SySch415/MITE-ESC/hardware/MITE_v1.csv

Reference | Qty | Value | DNP | Exclude from BOM | Exclude from Board | Footprint | MPN | Manufacturer | LCSC Part
Y_nrf_1 | 1 | Crystal_4pin_GND24 |  |  |  | Crystal:Crystal_SMD_3225-4Pin_3.2x2.5mm | ABM8AIG-16.000MHZ-12-2Z-T3 | Abracon
Y_M_1 | 1 | Crystal_4pin_GND24 |  |  |  | Crystal:Crystal_SMD_3225-4Pin_3.2x2.5mm | ABM8N-25.0000MHZ-10-D2Y-T3 | Abracon
U6 | 1 | NRF24L01 |  |  |  | Package_DFN_QFN:QFN-20-1EP_4x4mm_P0.5mm_EP2.5x2.5mm | NRF24L01P-R | Nordic Semiconductor
U4 | 1 | TB6612FNG |  |  |  | Package_SO:SSOP-24_5.3x8.2mm_P0.65mm | TB6612FNG,C,8,EL | Toshiba | C141517
U2,U3 | 2 | RY8336 |  |  |  | easyeda2kicad:ESOP-8_L4.9-W3.9-P1.27-LS6.0-BL-EP-1 | RY8336 | RYCHiP(蕊源) | C370879
U1 | 1 | STM32F411CEUx |  |  |  | Package_DFN_QFN:QFN-48-1EP_7x7mm_P0.5mm_EP5.6x5.6mm | STM32F411CEU6 | STMicroelectronics
SW_rst_2 | 1 | nrst_switch |  |  |  | Button_Switch_SMD:SW_Push_1P1T_NO_CK_KMR2 | KMR211NG LFS | C&K
SW_B_1 | 1 | boot switch |  |  |  | Button_Switch_SMD:SW_Push_1P1T_NO_CK_KMR2 | KMR211NG LFS | C&K
R_nrf_2 | 1 | 1M |  |  |  | Resistor_SMD:R_0603_1608Metric | RC0603FR-071ML | Yageo
R_nrf_1 | 1 | 22k |  |  |  | Resistor_SMD:R_0603_1608Metric | RC0603FR-0722KL | Yageo
R_L_2 | 1 | 5.1K |  |  |  | Resistor_SMD:R_0603_1608Metric | RC0603FR-075K1L | Yageo
R_L_1 | 1 | 1K |  |  |  | Resistor_SMD:R_0603_1608Metric | RC0603FR-071KL | Yageo
R_H_1 | 1 | 10k Ohm |  |  |  | Resistor_SMD:R_0603_1608Metric | RC0603FR-0710KL | Yageo
R_B_1,R_B_2 | 2 | 10K |  |  |  | Resistor_SMD:R_0603_1608Metric | RC0603FR-0710KL | Yageo
R2_5 | 1 | 44.05 kOhm |  |  |  | Resistor_SMD:R_0603_1608Metric | RC0603FR-0744K2L | Yageo
R1_5,R2_3.3,R3_5,R_EN_3.3,R_EN_5 | 5 | 10 kOhm |  |  |  | Resistor_SMD:R_0603_1608Metric | RC0603FR-0710KL | Yageo
R1_3.3 | 1 | 25.68 kOhm |  |  |  | Resistor_SMD:R_0603_1608Metric | RC0603FR-0725K5L | Yageo
Q1 | 1 | AO4407A |  |  |  | easyeda2kicad:SOIC-8_L4.9-W3.9-P1.27-LS6.0-BL | AO4407A | AOS | C16072
L_nrf_3 | 1 | 2.7nH |  |  |  | Inductor_SMD:L_0402_1005Metric | LQG15HS2N7S02D | Murata
L_nrf_2 | 1 | 3.9nH |  |  |  | Inductor_SMD:L_0402_1005Metric | LQG15HS3N9S02D | Murata
L_nrf_1 | 1 | 8.2nH |  |  |  | Inductor_SMD:L_0402_1005Metric | LQG15HS8N2J02D | Murata
L_M_1 | 1 | 10uH +-10% |  |  |  | Inductor_SMD:L_0603_1608Metric | LQM18DN100M70L | Murata
L1_3.3,L1_5 | 2 | 4.7uH |  |  |  | easyeda2kicad:IND-SMD_L3.0-W3.0_FTC303020D | FTC303018D4R7MBCA | cjiang (Changjiang Microelectronics) | C5832388
J1,J2 | 2 | JST-PH |  |  |  | Connector_JST:JST_PH_B2B-PH-K_1x02_P2.00mm_Vertical | B2B-PH-K-S(LF)(SN) | JST
D_L_2 | 1 | LED_pwr |  |  |  | LED_SMD:LED_0805_2012Metric | LTST-C171KRKT | Lite-On
D_L_1 | 1 | LED_pc13 |  |  |  | LED_SMD:LED_0805_2012Metric | LTST-C171TBKT | Lite-On
C_nrf_8,C_nrf_9 | 2 | 22pF |  |  |  | Capacitor_SMD:C_0402_1005Metric | GRM1555C1H220JA01D | Murata
C_nrf_7 | 1 | 2.2nF |  |  |  | Capacitor_SMD:C_0402_1005Metric | GRM155R71H222KA01D | Murata
C_nrf_6 | 1 | 4.7pF |  |  |  | Capacitor_SMD:C_0402_1005Metric | GRM1555C1H4R7CA01D | Murata
C_nrf_5 | 1 | 1.5pF |  |  |  | Capacitor_SMD:C_0402_1005Metric | GRM1555C1H1R5CA01D | Murata
C_nrf_4 | 1 | 1.0pF |  |  |  | Capacitor_SMD:C_0402_1005Metric | GRM1555C1H1R0CA01D | Murata
C_nrf_3 | 1 | 33nF |  |  |  | Capacitor_SMD:C_0402_1005Metric | GRM155R71C333KA01D | Murata
C_nrf_2 | 1 | 1nF |  |  |  | Capacitor_SMD:C_0402_1005Metric | GRM155R71H102KA01D | Murata
C_nrf_1,C_nrf_11 | 2 | 10nF |  |  |  | Capacitor_SMD:C_0402_1005Metric | GRM155R71H103KA88D | Murata
C_M_7 | 1 | 100 nF, X7R |  |  |  | Capacitor_SMD:C_0402_1005Metric | GRM155R71C104KA88D | Murata
C_M_4,C_M_5,C_M_6 | 3 | 100 nF, X7R, 16 V |  |  |  | C_0402_1005Metric | GRM155R71C104KA88D | Murata
C_M_3 | 1 | 2.2uF |  |  |  | Capacitor_SMD:C_0603_1608Metric | GRM188R61A475KE15D | Murata
C_M_1,C_M_2 | 2 | 4.3pF |  |  |  | Capacitor_SMD:C_0603_1608Metric | GRM1885C1H120JA01D | Murata
C_H_3 | 1 | 47uF |  |  |  | Capacitor_SMD:CP_Elec_6.3x5.4 | EEE-HA1E470WP | Panasonic
C_H_2 | 1 | 10uF |  |  |  | Capacitor_SMD:C_0603_1608Metric | GRM188R61E106MA73D | Murata
C_H_1 | 1 | 10uF |  |  |  | Capacitor_SMD:C_0603_1608Metric | GRM188R61A106KE69D | Murata
COUT_3.3,COUT_5 | 2 | 22x2uF |  |  |  | Capacitor_SMD:C_0603_1608Metric | GRM188R61A226ME15D | Murata
CIN_3.3,CIN_5 | 2 | 22uF |  |  |  | Capacitor_SMD:C_0603_1608Metric | GRM188R61E106MA73D | Murata
C1_3.3,C1_5,C_rst_1 | 3 | 100nF |  |  |  | Capacitor_SMD:C_0603_1608Metric | GRM188R71H104KA93D | Murata
AE1 | 1 | 50ohm |  |  |  | RF_Antenna:Johanson_2450AT43F0100 | 2450AT43F0100001E | Johanson Technology Inc.
