SySch415/MITE-ESC/hardware/crawler_schematic/crawler_schematic.kicad_pcb

## KiCad design hardware/crawler_schematic/crawler_schematic.kicad_pcb (2026-11-07)

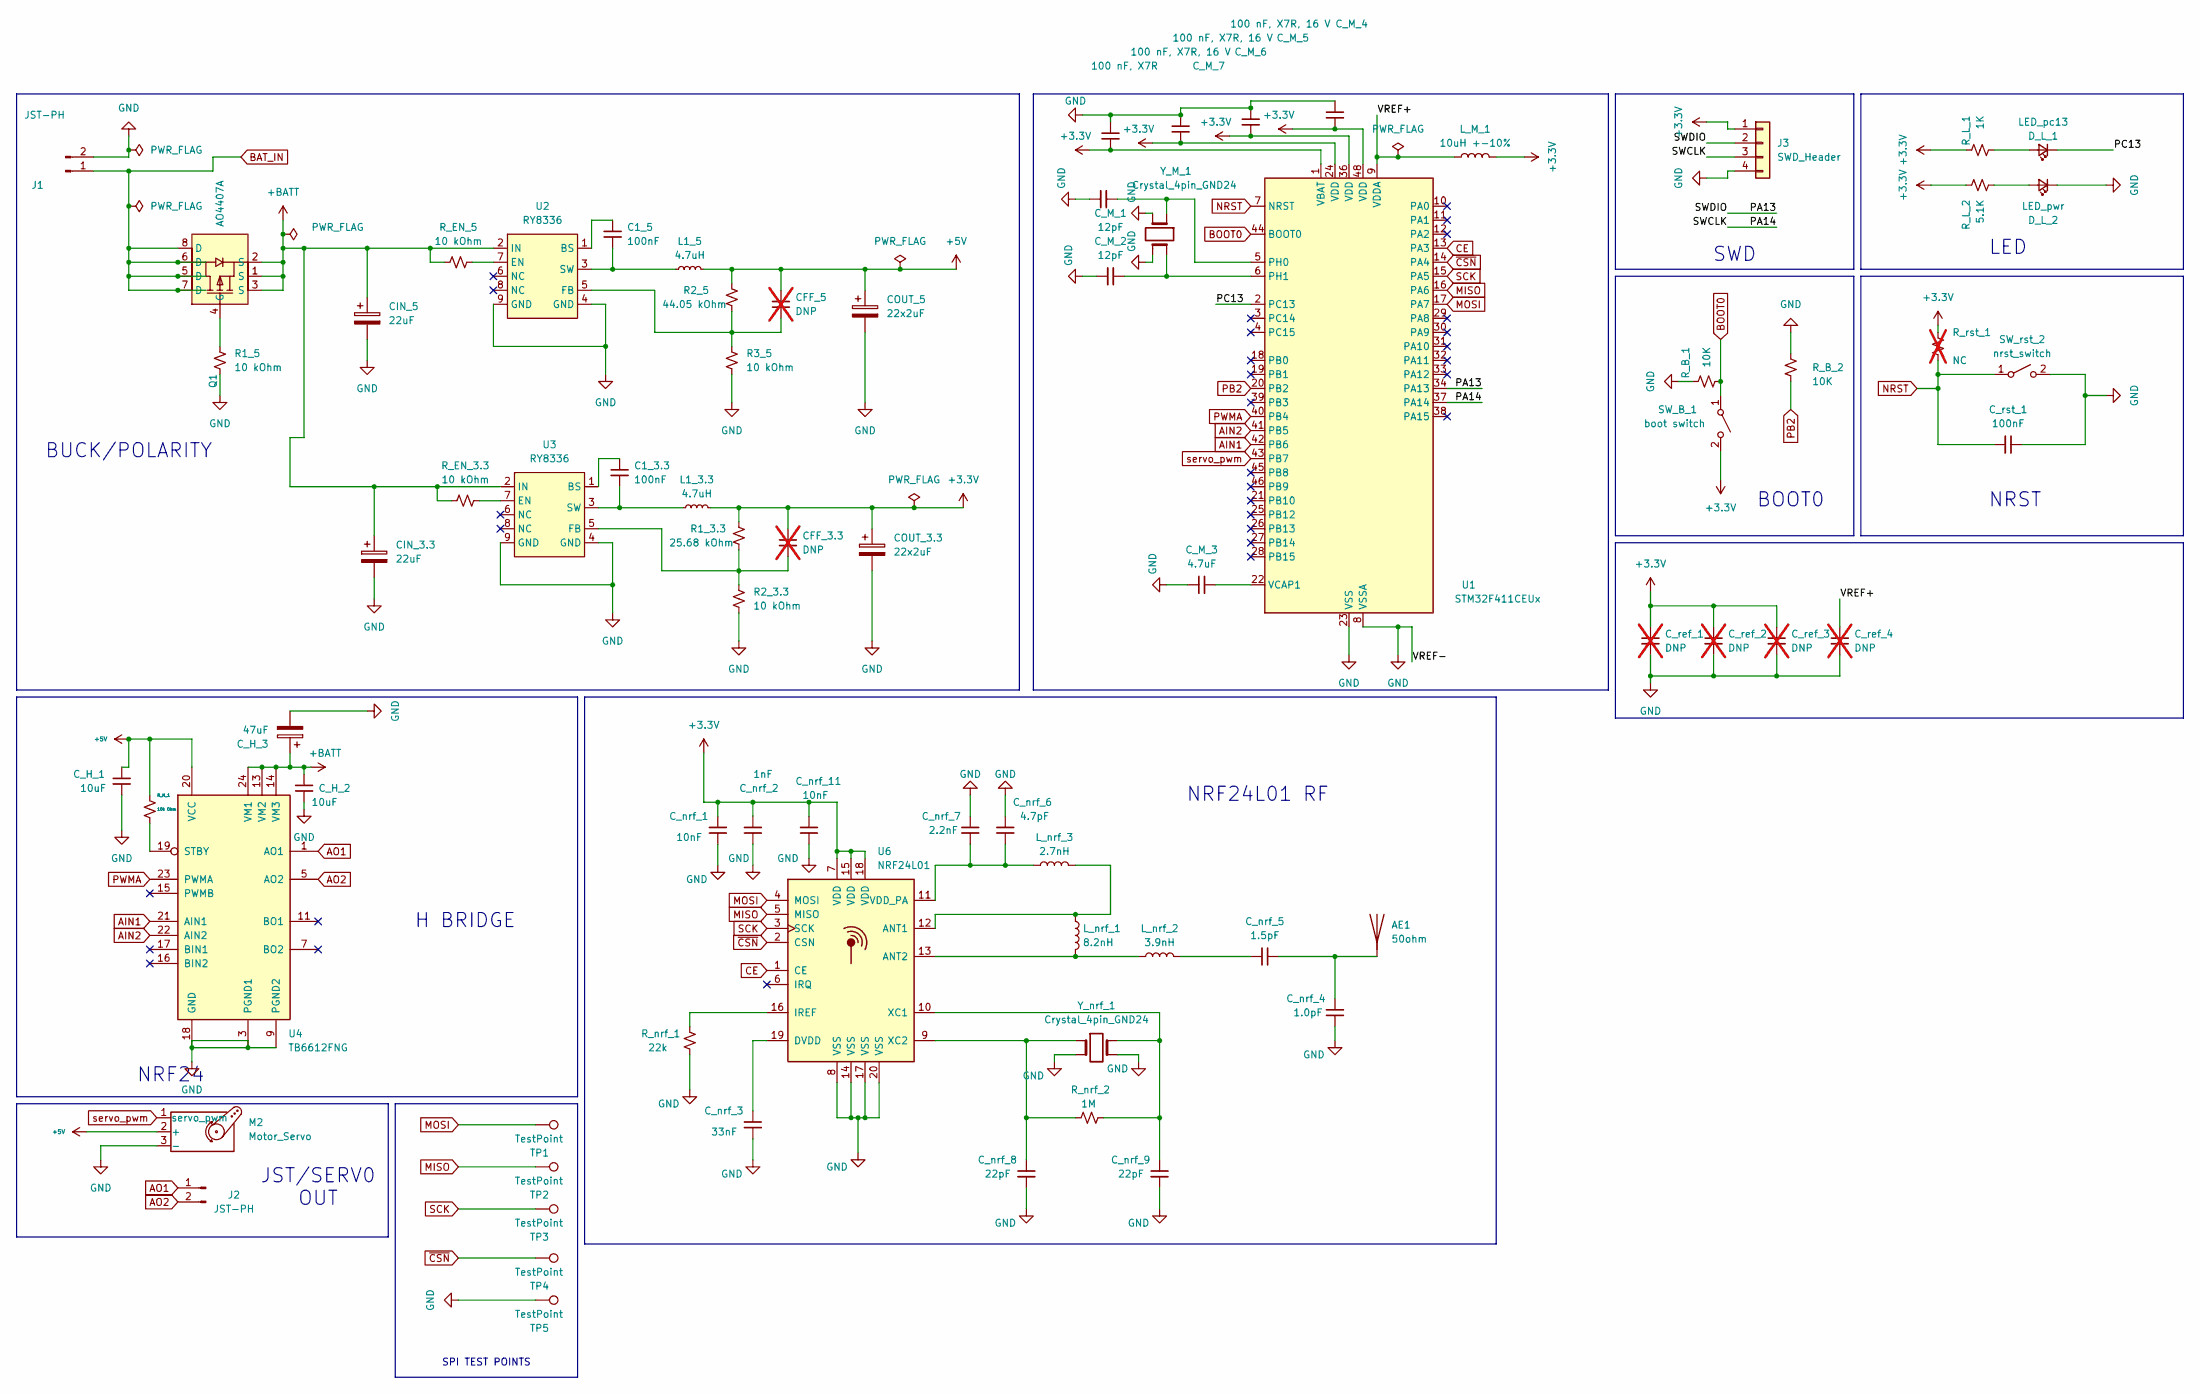
[picture p2: schematic crawler_schematic.kicad_sch, MITE v1]

Parts:
AE1: 50ohm; Johanson_2450AT43F0100; MPN 2450AT43F0100001E
C1_3.3, C1_5: 100nF; C_0603_1608Metric; MPN GRM188R71H104KA93D
CFF_3.3, CFF_5: DNP; C_0603_1608Metric; not fitted
CIN_3.3, CIN_5: 22uF; C_0603_1608Metric; MPN GRM188R61E106MA73D
COUT_3.3, COUT_5: 22x2uF; C_0603_1608Metric; MPN GRM188R61A226ME15D
C_H_1: 10uF; C_0603_1608Metric; MPN GRM188R61A106KE69D
C_H_2: 10uF; C_0603_1608Metric; MPN GRM188R61E106MA73D
C_H_3: 47uF; CP_Elec_6.3x5.4; MPN EEE-HA1E470WP
C_M_1, C_M_2: 12pF; C_0603_1608Metric; MPN GRM1885C1H120JA01D
C_M_3: 4.7uF; C_0603_1608Metric; MPN GRM188R61A475KE15D
C_M_4, C_M_5, C_M_6: 100 nF, X7R, 16 V; C_0402_1005Metric; MPN GRM155R71C104KA88D
C_M_7: 100 nF, X7R; C_0402_1005Metric; MPN GRM155R71C104KA88D
C_nrf_1, C_nrf_11: 10nF; C_0402_1005Metric; MPN GRM155R71H103KA88D
C_nrf_2: 1nF; C_0402_1005Metric; MPN GRM155R71H102KA01D
C_nrf_3: 33nF; C_0402_1005Metric; MPN GRM155R71C333KA01D
C_nrf_4: 1.0pF; C_0402_1005Metric; MPN GRM1555C1H1R0CA01D
C_nrf_5: 1.5pF; C_0402_1005Metric; MPN GRM1555C1H1R5CA01D
C_nrf_6: 4.7pF; C_0402_1005Metric; MPN GRM1555C1H4R7CA01D
C_nrf_7: 2.2nF; C_0402_1005Metric; MPN GRM155R71H222KA01D
C_nrf_8, C_nrf_9: 22pF; C_0402_1005Metric; MPN GRM1555C1H220JA01D
C_ref_1, C_ref_2, C_ref_3, C_ref_4: DNP; C_0603_1608Metric; not fitted
C_rst_1: 100nF; C_0603_1608Metric; MPN GRM188R71H104KA93D
D_L_1: LED_pc13; LED_0805_2012Metric; MPN LTST-C171TBKT
D_L_2: LED_pwr; LED_0805_2012Metric; MPN LTST-C171KRKT
J1, J2: JST-PH; JST_PH_B2B-PH-K_1x02_P2.00mm_Vertical; MPN B2B-PH-K-S(LF)(SN)
J3: SWD_Header; PinHeader_1x04_P2.54mm_Vertical
L1_3.3, L1_5: 4.7uH; IND-SMD_L3.0-W3.0_FTC303020D; MPN FTC303018D4R7MBCA; LCSC Part C5832388
L_M_1: 10uH +-10%; L_0603_1608Metric; MPN LQM18DN100M70L
L_nrf_1: 8.2nH; L_0402_1005Metric; MPN LQG15HS8N2J02D
L_nrf_2: 3.9nH; L_0402_1005Metric; MPN LQG15HS3N9S02D
L_nrf_3: 2.7nH; L_0402_1005Metric; MPN LQG15HS2N7S02D
M2: Motor_Servo; PinHeader_1x03_P2.54mm_Vertical
Q1: AO4407A; SOIC-8_L4.9-W3.9-P1.27-LS6.0-BL; MPN AO4407A; LCSC Part C16072
R1_3.3: 25.68 kOhm; R_0603_1608Metric; MPN RC0603FR-0725K5L
R1_5, R2_3.3, R3_5: 10 kOhm; R_0603_1608Metric; MPN RC0603FR-0710KL
R2_5: 44.05 kOhm; R_0603_1608Metric; MPN RC0603FR-0744K2L
R_B_1, R_B_2: 10K; R_0603_1608Metric; MPN RC0603FR-0710KL
R_EN_3.3, R_EN_5: 10 kOhm; R_0603_1608Metric; MPN RC0603FR-0710KL
R_H_1: 10k Ohm; R_0603_1608Metric; MPN RC0603FR-0710KL
R_L_1: 1K; R_0603_1608Metric; MPN RC0603FR-071KL
R_L_2: 5.1K; R_0603_1608Metric; MPN RC0603FR-075K1L
R_nrf_1: 22k; R_0603_1608Metric; MPN RC0603FR-0722KL
R_nrf_2: 1M; R_0603_1608Metric; MPN RC0603FR-071ML
R_rst_1: NC; R_0603_1608Metric; not fitted
SW_B_1: boot switch; SW_Push_1P1T_NO_CK_KMR2; MPN KMR211NG LFS
SW_rst_2: nrst_switch; SW_Push_1P1T_NO_CK_KMR2; MPN KMR211NG LFS
TP1, TP2, TP3, TP4, TP5: TestPoint; TestPoint_Pad_D1.5mm
U1: STM32F411CEUx; QFN-48-1EP_7x7mm_P0.5mm_EP5.6x5.6mm; MPN STM32F411CEU6
U2, U3: RY8336; ESOP-8_L4.9-W3.9-P1.27-LS6.0-BL-EP-1; MPN RY8336; LCSC Part C370879
U4: TB6612FNG; SSOP-24_5.3x8.2mm_P0.65mm; MPN TB6612FNG,C,8,EL; LCSC Part C141517
U6: NRF24L01; QFN-20-1EP_4x4mm_P0.5mm_EP2.5x2.5mm; MPN NRF24L01P-R
Y_M_1: Crystal_4pin_GND24; Crystal_SMD_3225-4Pin_3.2x2.5mm; MPN ABM8N-25.0000MHZ-10-D2Y-T3
Y_nrf_1: Crystal_4pin_GND24; Crystal_SMD_3225-4Pin_3.2x2.5mm; MPN ABM8AIG-16.000MHZ-12-2Z-T3

Connections:
+3.3V: CFF_3.3.1, COUT_3.3.1, C_M_4.2, C_M_5.2, C_M_6.2, C_M_7.2, C_nrf_1.1, C_nrf_2.1, C_nrf_11.1, C_ref_1.1, C_ref_2.1, C_ref_3.1, J3.1, L1_3.3.2, L_M_1.2, R1_3.3.2, R_L_1.2, R_L_2.2, R_rst_1.1, SW_B_1.2 (B), U1.1 (VBAT), U1.24 (VDD), U1.36 (VDD), U1.48 (VDD), U6.7 (VDD), U6.15 (VDD), U6.18 (VDD)
+5V: CFF_5.1, COUT_5.1, C_H_1.1, L1_5.2, M2.2 (+), R2_5.2, R_H_1.1, U4.20 (VCC)
+BATT: CIN_3.3.1, CIN_5.1, C_H_2.1, C_H_3.1, Q1.1 (S), Q1.2 (S), Q1.3 (S), R_EN_3.3.2, R_EN_5.2, U2.2 (IN), U3.2 (IN), U4.13 (VM2), U4.14 (VM3), U4.24 (VM1)
/PA13: J3.2, U1.34 (PA13)
/PA14: J3.3, U1.37 (PA14)
/PC13: D_L_1.1 (K), U1.2 (PC13)
/VREF+: C_ref_4.1, L_M_1.1, U1.9 (VDDA)
AIN1: U1.42 (PB6), U4.21 (AIN1)
AIN2: U1.41 (PB5), U4.22 (AIN2)
AO1: J2.1, U4.1 (AO1), U4.2 (AO1)
AO2: J2.2, U4.5 (AO2), U4.6 (AO2)
BAT_IN: J1.1, Q1.5 (D), Q1.6 (D), Q1.7 (D), Q1.8 (D)
BOOT0: R_B_1.1, SW_B_1.1 (A), U1.44 (BOOT0)
CE: U1.13 (PA3), U6.1 (CE)
GND: CIN_3.3.2, CIN_5.2, COUT_3.3.2, COUT_5.2, C_H_1.2, C_H_2.2, C_H_3.2, C_M_1.1, C_M_2.1, C_M_3.1, C_M_4.1, C_M_5.1, C_M_6.1, C_M_7.1, C_nrf_1.2, C_nrf_2.2, C_nrf_3.2, C_nrf_4.2, C_nrf_6.1, C_nrf_7.1, C_nrf_8.2, C_nrf_9.2, C_nrf_11.2, C_ref_1.2, C_ref_2.2, C_ref_3.2, C_ref_4.2, C_rst_1.2, D_L_2.1 (K), J1.2, J3.4, M2.3 (-), R1_5.1, R2_3.3.1, R3_5.1, R_B_1.2, R_B_2.1, R_nrf_1.2, SW_rst_2.2 (B), TP5.1 (1_1), U1.8 (VSSA), U1.23 (VSS), U1.35 (VSS), U1.47 (VSS), U1.49 (VSS), U2.4 (GND), U2.9 (GND), U3.4 (GND), U3.9 (GND), U4.3 (PGND1), U4.4 (PGND1), U4.9 (PGND2), U4.10 (PGND2), U4.18 (GND), U6.8 (VSS), U6.14 (VSS), U6.17 (VSS), U6.20 (VSS), Y_M_1.2 (GND), Y_M_1.4 (GND), Y_nrf_1.2 (GND), Y_nrf_1.4 (GND)
MISO: TP2.1 (1_1), U1.16 (PA6), U6.5 (MISO)
MOSI: TP1.1 (1_1), U1.17 (PA7), U6.4 (MOSI)
NRST: C_rst_1.1, R_rst_1.2, SW_rst_2.1 (A), U1.7 (NRST)
unnamed: AE1.1 (A_1), C_nrf_4.1, C_nrf_5.2
unnamed: C_nrf_5.1, L_nrf_2.2
unnamed: D_L_1.2 (A), R_L_1.1
unnamed: D_L_2.2 (A), R_L_2.1
unnamed: Q1.4 (G), R1_5.2
unnamed: C_M_1.2, U1.5 (PH0), Y_M_1.1
unnamed: C_M_2.2, U1.6 (PH1), Y_M_1.3
unnamed: C_M_3.2, U1.22 (VCAP1)
unnamed: C1_5.1, U2.1 (BS)
unnamed: R_EN_5.1, U2.7 (EN)
unnamed: CFF_5.2, R2_5.1, R3_5.2, U2.5 (FB)
unnamed: C1_5.2, L1_5.1, U2.3 (SW)
unnamed: C1_3.3.1, U3.1 (BS)
unnamed: R_EN_3.3.1, U3.7 (EN)
unnamed: CFF_3.3.2, R1_3.3.1, R2_3.3.2, U3.5 (FB)
unnamed: C1_3.3.2, L1_3.3.1, U3.3 (SW)
unnamed: R_H_1.2, U4.19 (STBY)
unnamed: L_nrf_1.1, L_nrf_3.2, U6.12 (ANT1)
unnamed: L_nrf_1.2, L_nrf_2.1, U6.13 (ANT2)
unnamed: C_nrf_3.1, U6.19 (DVDD)
unnamed: R_nrf_1.1, U6.16 (IREF)
unnamed: C_nrf_6.2, C_nrf_7.2, L_nrf_3.1, U6.11 (VDD_PA)
unnamed: C_nrf_9.1, R_nrf_2.1, U6.10 (XC1), Y_nrf_1.3
unnamed: C_nrf_8.1, R_nrf_2.2, U6.9 (XC2), Y_nrf_1.1
PB2: R_B_2.2, U1.20 (PB2)
PWMA: U1.40 (PB4), U4.23 (PWMA)
SCK: TP3.1 (1_1), U1.15 (PA5), U6.3 (SCK)
servo_pwm: M2.1 (servo_pwm), U1.43 (PB7)
~CSN: TP4.1 (1_1), U1.14 (PA4), U6.2 (CSN)

Notes on the sheet:
LED
SPI TEST POINTS
NRF24L01 RF
BUCK/POLARITY
BOOT0
JST/SERV0 OUT
H BRIDGE
NRST
SWD
NRF24

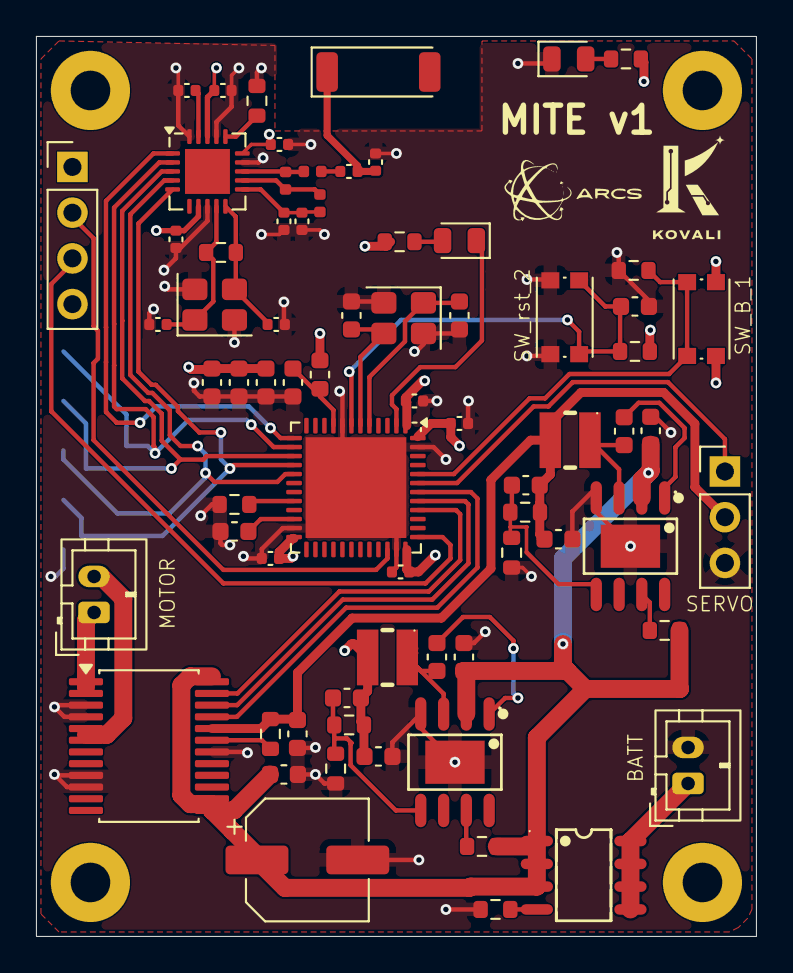
[picture p3: board crawler_schematic.kicad_pcb from above]

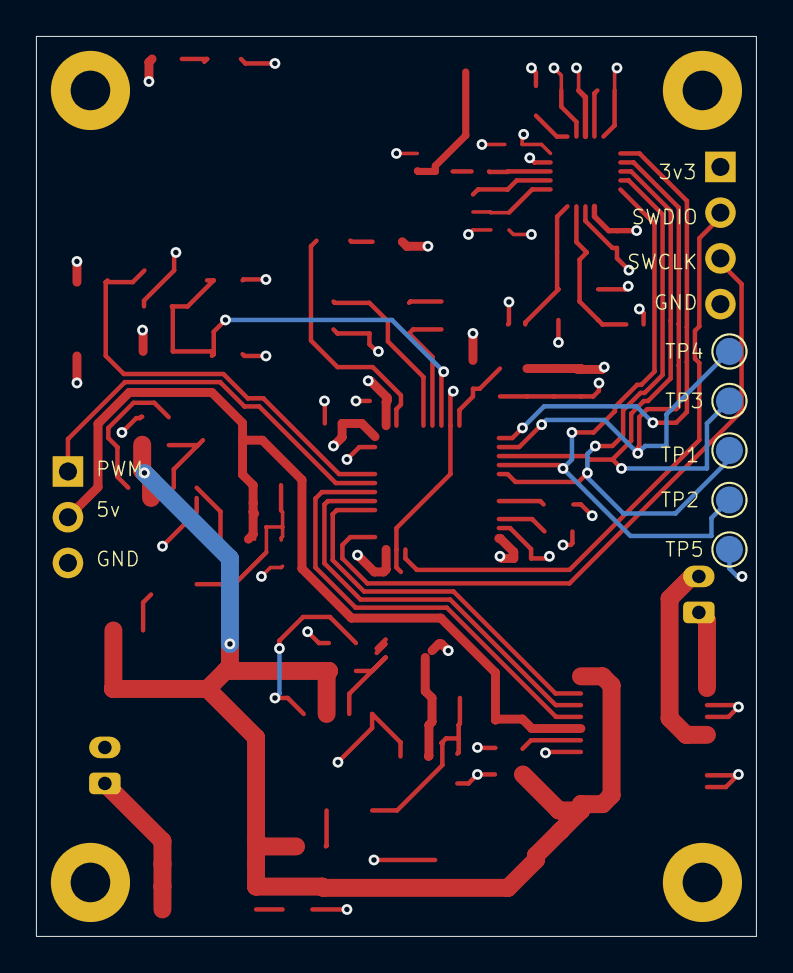
[picture p4: board crawler_schematic.kicad_pcb from below]

Board: 4 copper layers, 40.0 x 50.0 mm, 76 parts (5 on the bottom side), 47 nets.
