SySch415/MITE-ESC/(commit log)

2026-11-02 fix: v1 design rules, reroute SPI
    [crawler_schematic.kicad_pcb, crawler_schematic.kicad_sch]
2026-11-02 add: new 3d render, update: README
    [crawler_schematic.kicad_pcb]
2026-11-06 add: BOM, extend gnd plane across top layer, rotate 25mhz crystal, verify impedance of nrf24 network
    [MITE_v1_BOM.csv, crawler_schematic.kicad_pcb, crawler_schematic.kicad_sch]
2026-11-06 update: update gitignore
    [crawler_schematic.kicad_pcb]
2026-11-06 update: part numbers for BOM, update render
    [MITE_v1.csv, MITE_v1_BOM.csv, crawler_schematic.kicad_pcb, crawler_schematic.kicad_sch]
2026-11-07 update: values for vcap and crystal load caps
    [crawler_schematic.kicad_sch]
